luisclement/DIY-2-DOF-Simulator/Screenshot 2026-03-22 084635.png

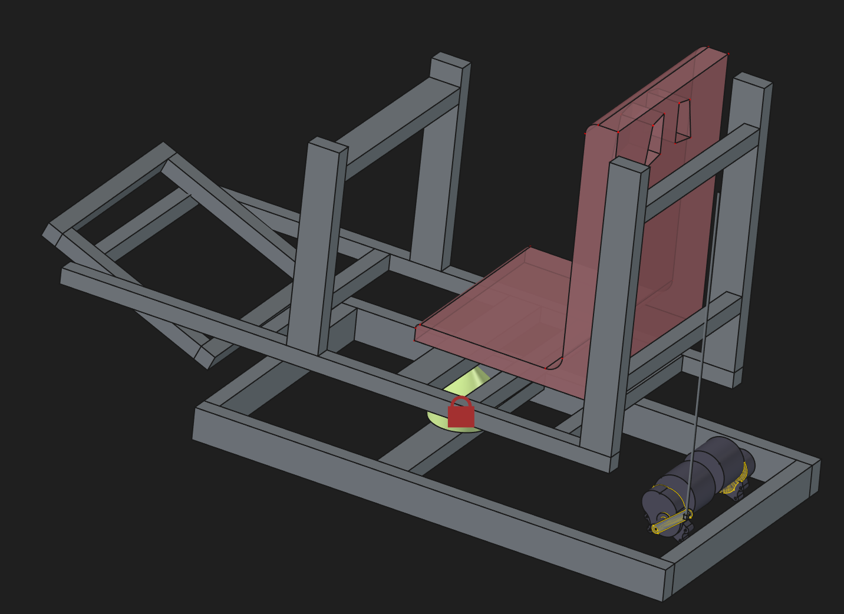
Screenshot 2026-03-22 084635.png
