luisclement/DIY-2-DOF-Simulator/(commit log)

2026-03-01 Add build guide for 2-DOF motion simulator
    Added detailed documentation for the 2-DOF motion simulator build, covering mechanical design, hardware specifications, electrical systems, wiring, and software control.
2026-03-01 Add Bill of Materials section to README
    Added a Bill of Materials section with specifications for various components.
2026-03-01 Add aluminium profile build guide for 2-DOF motion simulator
    Added a comprehensive build guide for a 2-DOF motion simulator, detailing mechanical design, hardware specs, electrical systems, wiring, and software control.
2026-03-01 Add Aluminum Profile BOM & Cut List to README
    Added Aluminum Profile BOM and Cut List sections with detailed specifications for moving platform and fixed base components.
2026-03-01 Add electrical wiring and schematic details to README
    Added detailed electrical wiring and schematic information for the motion simulator, including control, power, and protection paths, along with a wiring diagram and connection standards.
2026-03-02 Update connectors and add ergonomics section
    Added a new section on ergonomics and layout for pilot seating and pedal setup.
2026-03-07 Add Lever Arm Optimization section to README
    Added section on Lever Arm Optimization and its benefits for racing and flight simulation.
2026-03-08 Change capacitor rating from 35V to 63V
    Updated capacitor specifications in safety section and wiring table.
2026-03-15 Update README with SMC3 testing instructions
    Added important note regarding motor and potentiometer direction during testing with SMC3.
2026-03-21 Add motor testing instructions to README
    Added instructions for testing motors with SMC3.
2026-03-22 Enhance README with motor testing and programming details
    Expanded section on testing and programming motor limits with SMC3, including safety advice and control logic hierarchy.
2026-03-22 Enhance README with cost and kinematics analysis
    Added detailed cost estimate and specifications for the motion simulator.
2026-03-22 Modify SMC3 settings for improved motor feedback
    Updated the SMC3 configuration to adjust motor feedback mapping for a 92-degree swing, ensuring proper motor control and limits.
2026-03-24 Add SMC3 profile image to README
    Added current working SMC3 profile image to README.
2026-03-26 Add files via upload
    This is my SMC3.ino modified version to get motors up and running for settings and they move slowly to center
2026-04-12 Add 2DOF Motion Rig stability & protection profile
    Added a new section on 2DOF Motion Rig stability and protection profile, including firmware settings, hardware protection logic, software filtering, and hardware health audit.
2026-04-12 Update print statement from 'Hello' to 'Goodbye'
2026-04-17 Add documentation for Simube Hub V1.5 Button Plate
    Added detailed documentation for wiring and configuration of a GT3-style button plate using the Simube Hub V1.5, including pin mapping, hardware connections, and software setup instructions.
2026-04-17 Update Simube Hub V1.5 DIY Button Plate Project
2026-04-17 Create Fan 24V pinout.md
2026-04-17 Add documentation for Simube Hub V1.5 DIY Button Plate
    This documentation provides wiring and configuration details for a GT3-style button plate using the Simube Hub V1.5. It includes pin mapping, hardware connection instructions, and software configuration for SimHub.
